ami123-coding/Robotics-Arm/wiring/wiring_diagram.png

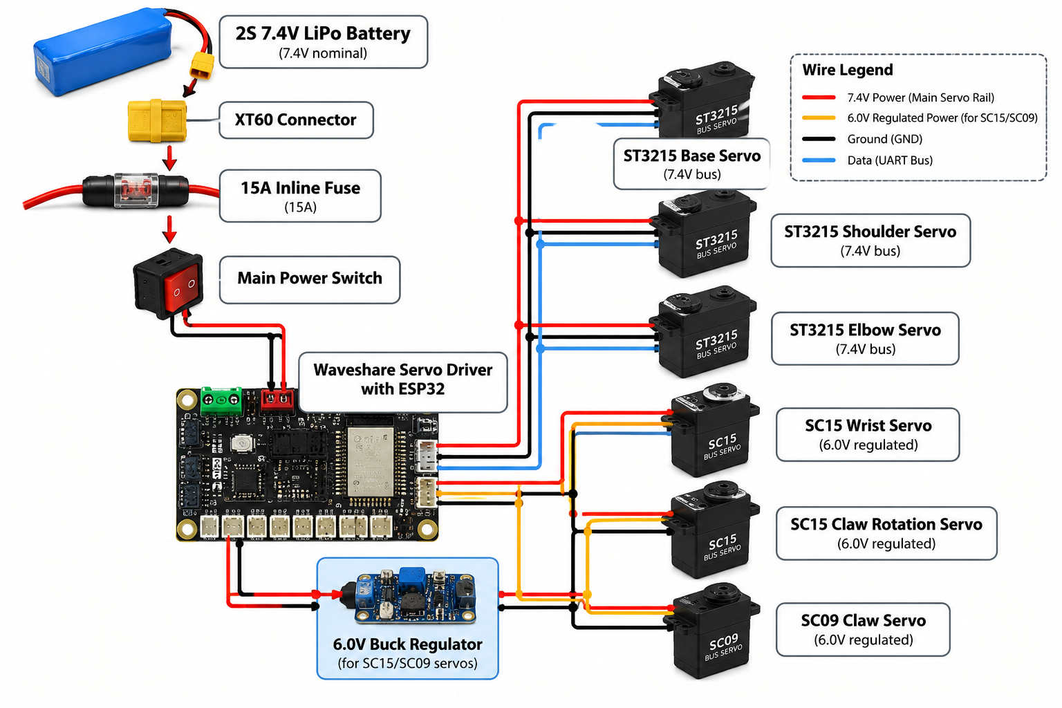
wiring/wiring_diagram.png
