ami123-coding/Robotics-Arm/images/_claw.png

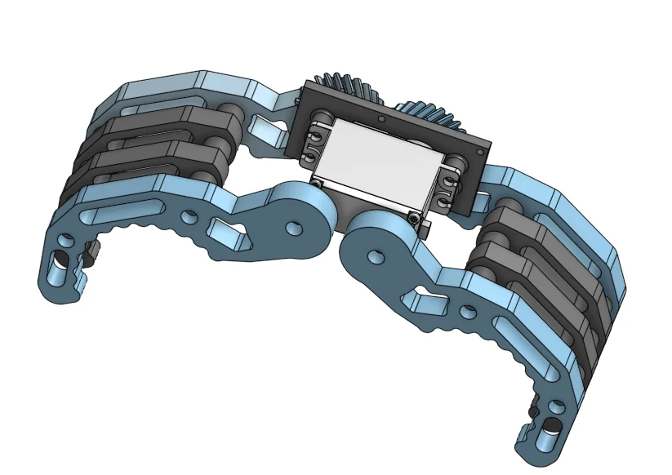
images/_claw.png
