ami123-coding/Robotics-Arm/images/_base.png

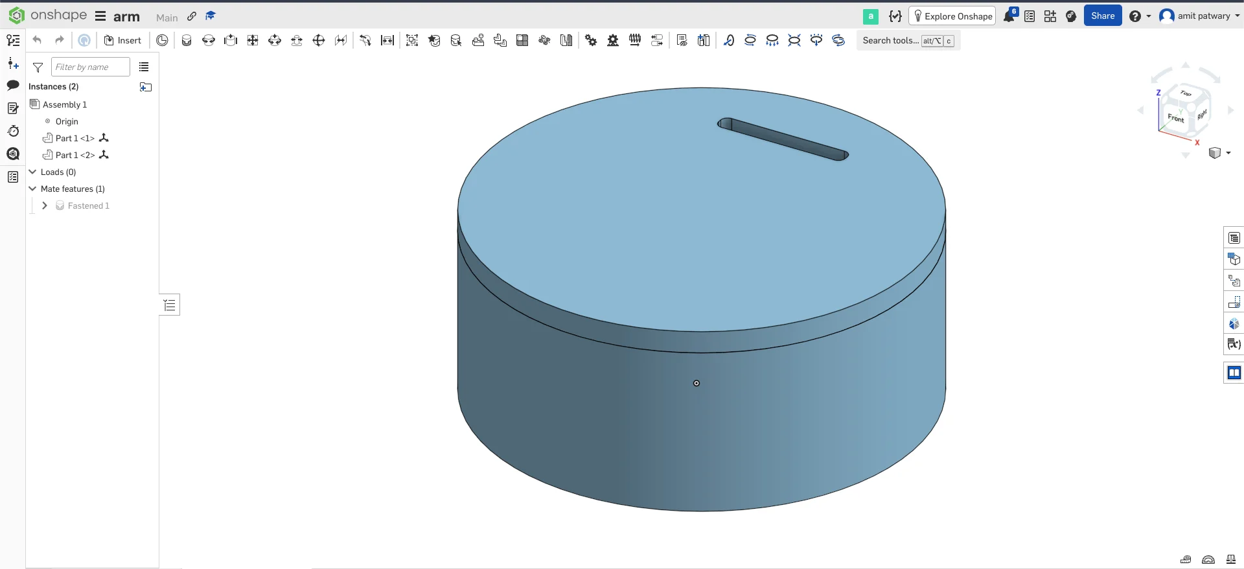
images/_base.png
