ami123-coding/Robotics-Arm/images/armrotatingservomount.png

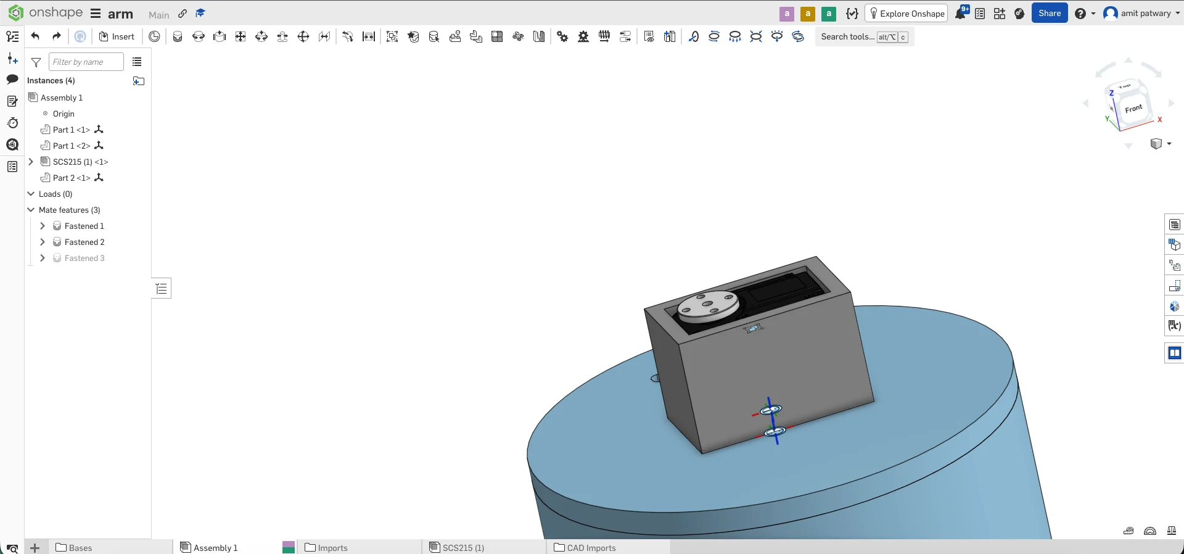
images/armrotatingservomount.png
