ami123-coding/Robotics-Arm/images/armsadded.png

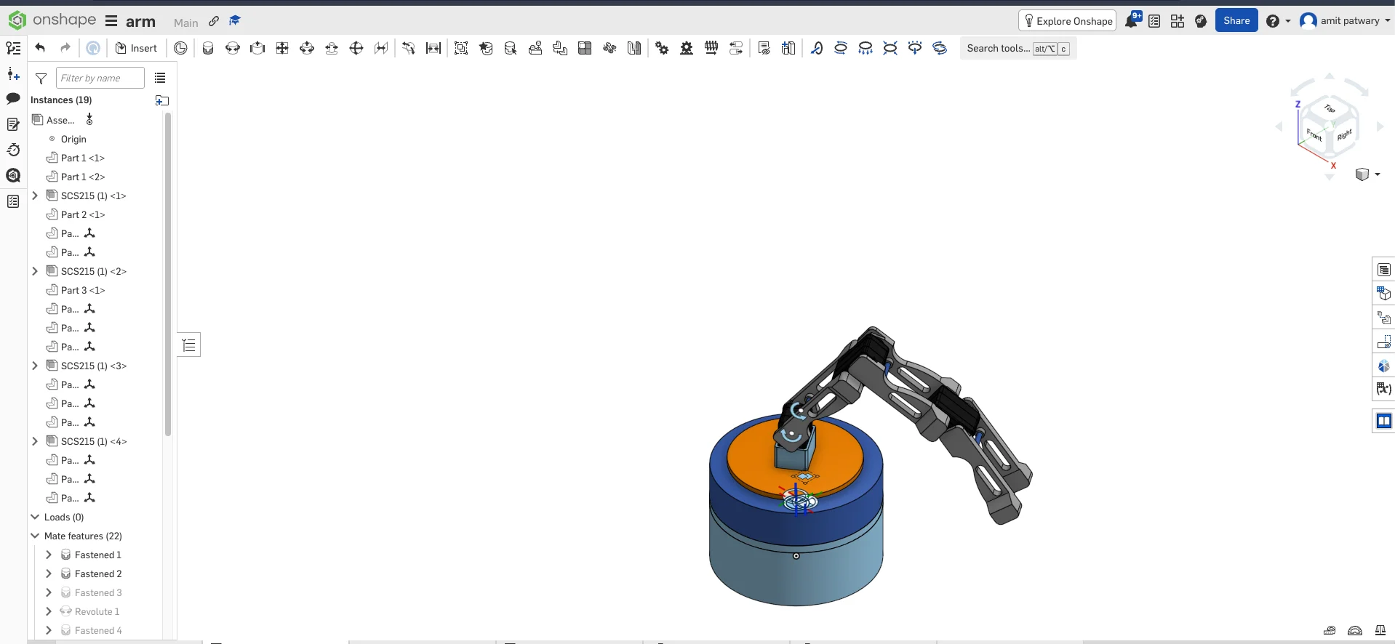
images/armsadded.png
