ami123-coding/Robotics-Arm/images/clawroatingseroandmount.png

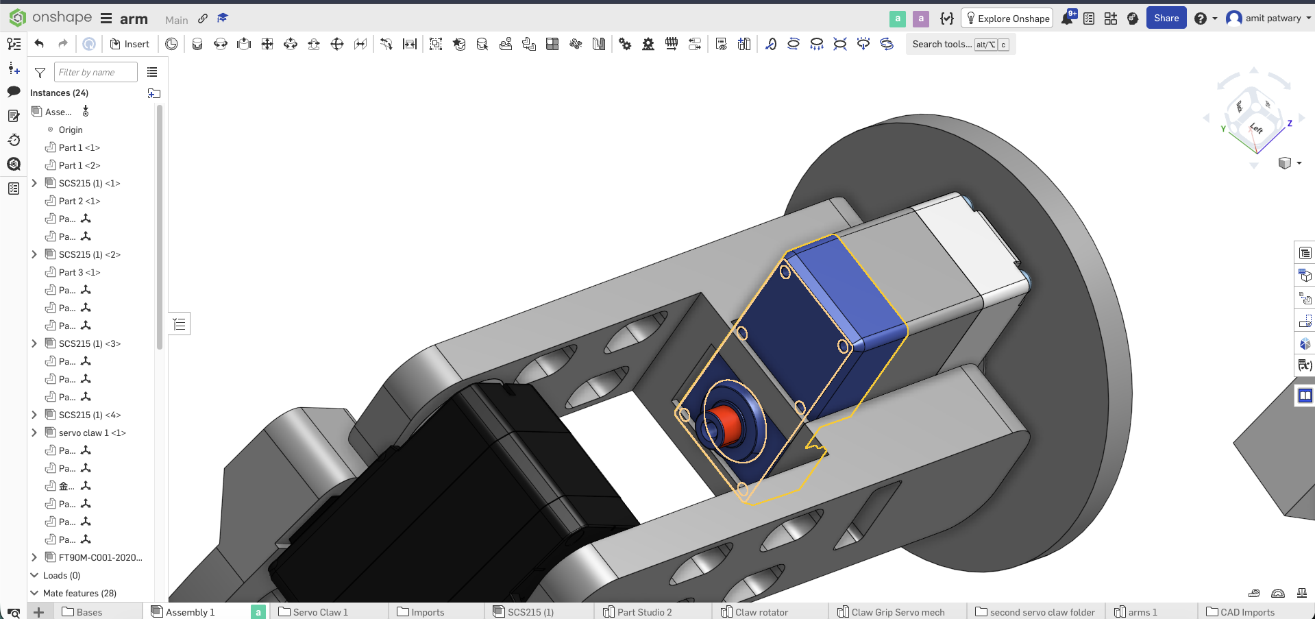
images/clawroatingseroandmount.png
