ami123-coding/Robotics-Arm/images/finishedfull.png

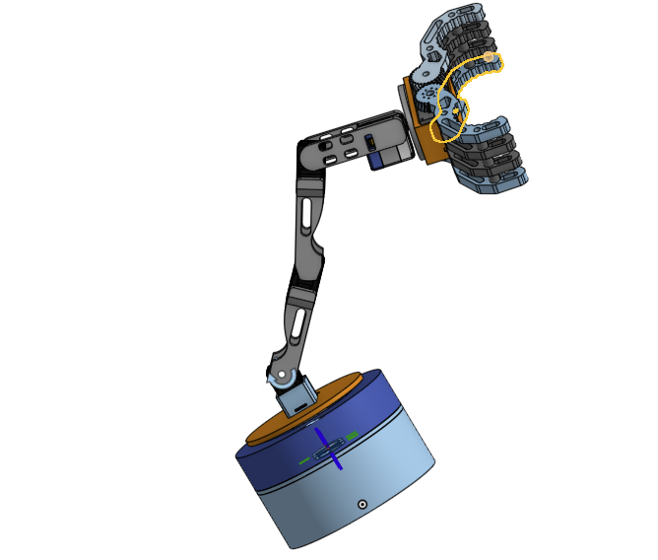
images/finishedfull.png
