ami123-coding/Robotics-Arm/images/shoulder servo.png

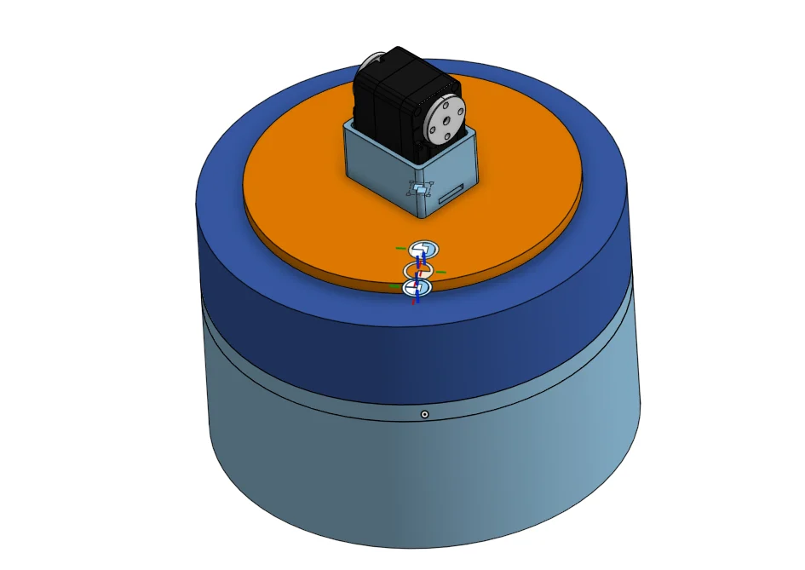
images/shoulder servo.png
