ami123-coding/Robotics-Arm/CAD/Robotic_Arm_Full_Assembly.step

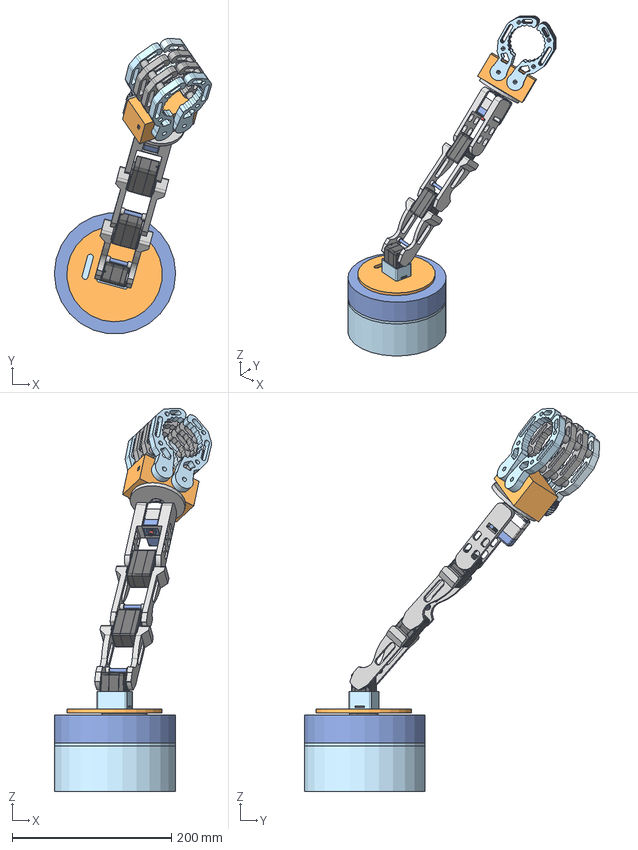
[picture p9: CAD file, 2026-10-11]
CAD/Robotic_Arm_Full_Assembly.step
197.6 x 371.0 x 481.2 mm
Support Claw x 2
ClawP1
Servo Motor
Casing1
ClawP4
ClawP2
金属舵盘（驱动） v2:1__实体1 x 5
Casing2
GE_27:1__实体1 x 4
SG-ZIJI_15:1__实体1 x 4
MOTOR-1723_3:1__实体1 x 4
ZK_122:1__实体1 x 4
PCB-CHAZUO_92:1__实体1 x 4
XG-ZIJI_16:1__实体1 x 4
金属舵盘（从动） v2:1__实体1 x 4
PH2-3PIN x 2
OUTPUTGEAR
M20X30 x 4
SC15-PCB-A
MAINPCB-PH2-AMP-20210107
PAIZHING2-54
ClawP3
