ami123-coding/Robotics-Arm/wiring/wiring diagram.png

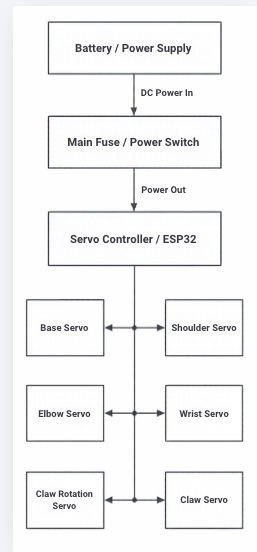
wiring/wiring diagram.png
