ami123-coding/Robotics-Arm/(commit log)

2026-10-11 Enhance README with detailed project information
    Expanded project description and added details about features, design, electronics, firmware, bill of materials, and build journal.
2026-10-11 Add bill of materials for robot components
    [BOM.csv]
2026-10-11 Update JOURNAL.md with build progress details
    Documented the progress and details of the robotic arm build project, including plans, components added, and time spent on each task.
2026-10-11 Add source CAD section with Onshape link
    Added a section for the source CAD files and included a link to the Onshape document.
2026-10-11 Add written explanation for robotic arm wiring
    Added a detailed explanation of the robotic arm's power and control system, including components and their functions.
2026-10-11 Initialize robotic arm firmware with setup and loop
    Added initial setup and loop functions for robotic arm control.
2026-10-11 Document progress on robotic arm assembly in JOURNAL.md
    Updated the journal with detailed entries on the robotic arm's development, including the addition of servos, claw mechanism, and final assembly.
2026-10-11 Revise JOURNAL.md for robotic arm build details
    Updated the journal to reflect changes in the robotic arm project, including detailed descriptions of components and assembly steps.
2026-10-13 Revise project journal with updates and corrections
    Updated project details, improved design descriptions, and added images for clarity. Adjusted total time spent on various tasks and ensured proper wire routing in the final design.
2026-10-13 Revise JOURNAL.md with detailed project progress
    Updated journal entries with detailed descriptions of the design and assembly process for the robotic arm, including modifications made for servo placements and wire management.
